SempaiEcchi/iot-quake/SEMINAR.pptx

Umreženi sustav za detekciju potresa

ESP32 · MPU6050 · MQTT · correlation rule dvaju channela

Leo Radočaj
Sveučilište Jurja Dobrile u Puli · Fakultet informatike u Puli
Seminarski rad iz kolegija Internet stvari (IoT) · 2025./2026.

Notes: Naslovna. Predstaviti temu: jedan jeftini node, ali s protokolom koji razlikuje lokalni noise od ground motiona.

## Slide 2

Problem: jedan senzor ne zna što je potres

Kamion, vrata, lakat na stolu

Lokalni noise. Trese jedan senzor, druge ne dotiče. Akcelerometar to vidi jednako kao potres.

Correlation rule

distinct channela
unutar 2 sekunde

Tek tada je to potres. Isti pristup koriste dense low-cost arrays (Community Seismic Network, MyShake): pouzdanost dolazi iz istodobnosti, ne iz kvalitete pojedinog senzora.

Scope: jedan ESP32. Drugi channel je simuliran (fake_node.py) i govori isti MQTT contract; stvarni drugi node je drop-in bez izmjene koda.

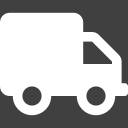
[picture p4: figure]

2

Ground motion

Pogađa sve senzore istodobno. Lokalni noise je lokalan, ground motion nije. To je jedina razlika koju možemo mjeriti jeftino.

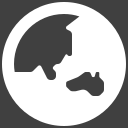
[picture p5: figure]

Leo Radočaj · Fakultet informatike u Puli

2

Notes: Motivacija. Jedan akcelerometar ne razlikuje lokalni noise od ground motiona; zahtjev da se dva channela slože je najjeftinija diskriminacija.

## Slide 3

Arhitektura sustava

ESP32 + MPU6050

channel A · stvarni

Correlator

python · paho-mqtt

quake/alarm

→ buzzer

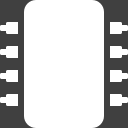
[picture p6: figure]

Mosquitto

MQTT broker · Docker

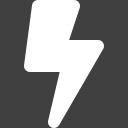
[picture p7: figure]
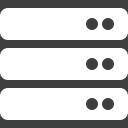
[picture p8: figure]

fake_node.py

channel B · simulirani

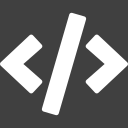
[picture p9: figure]

Dashboard

localhost:8000 · SSE

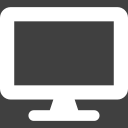
[picture p10: figure]

Thingsboard

optional

Dashboard subscribea na broker, ne na correlator

Detection ne smije ovisiti o tome je li browser otvoren. Gašenje dashboarda ne mijenja ništa u ponašanju alarma.

Leo Radočaj · Fakultet informatike u Puli

Broker ostaje lokalan

Demo preživljava nestanak interneta: eventi, korelacija, alarm i buzzer rade dalje. Bridge prema cloudu živi u correlatoru, pa node ostaje plaintext bez TLS-a.

3

## Slide 4

Hardver: ~¥3.100 na breadboardu

Komponenta | Kol. | Cijena
ESP32 (FREENOVE FNK0090, WROOM-32E, 4 MB) | 1 | ¥1.800
MPU6050 / GY-521 akcelerometar | 1 | ~¥300
Aktivni buzzer, 3-pin modul | 1 | ~¥100
Breadboard | 1 | ~¥300
Jumper wires | 1 set | ~¥400
LED 5 mm + otpornik 330 Ω | 1 | ~¥200

Wiring

MPU6050 VCC ── 3V3 (3,3 V, NE 5 V)
GND ── GND
SCL ── GPIO27
SDA ── GPIO26
LED ── GPIO2 (onboard)
Buzzer ── GPIO25

Izmjereno, ne pretpostavljeno

- FNK0090 ima 40 pinova, ne 38
- Buzzer je active-LOW
- MPU6050 treba ~150 ms settle nakon power-upa prije prvog I2C upita

Leo Radočaj · Fakultet informatike u Puli

4

## Slide 5

Firmware: sampling i detection

detector.cpp · bez Arduino headera · dev prema prethodnom baselineu

dev = |mag − baseline|
baseline = 0.99·baseline + 0.01·mag
if dev > THRESHOLD and not refractory:
trigger()

EMA kao high-pass filter

Uklanja ~980 gal gravity offseta bez filter biblioteke i prati nagib node-a. Deviation prema prethodnom baselineu: spike prijavi punu amplitudu.

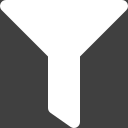
[picture p11: figure]

Warm-up 3 s

Baseline se seeda prvim sampleom, ali EMA se još smiruje. Prve 3 sekunde nema triggera.

Sampling

- 100 Hz, gate na micros(); ±2 g, 16384 LSB/g, gal = g · 980,665
- DLPF u senzoru (0x1A = 6) → bandwidth 5 Hz; bez toga noise je ~7× veći
- Sample gate se resyncira umjesto da sustiže: stall ne smije ispaliti burst
- MQTT reconnect s exponential backoffom (2 s → 30 s); blocking reconnect je rušio 100 Hz na 1 Hz

Leo Radočaj · Fakultet informatike u Puli

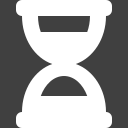
[picture p12: figure]

Refractory period 5 s

Jedan shake = jedan event, ne stotine. Publish kad se window zatvori: peak_gal je stvarni peak, dur_ms trajanje iznad thresholda.

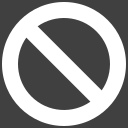
[picture p13: figure]

5

## Slide 6

MQTT contract: tri topica, tri JSON payloada

Topic | Smjer | Payload | Kada
quake/<node_id>/event | node → broker | {"node","peak_gal","dur_ms"} | na trigger
quake/<node_id>/tel | node → broker | {"node","dev_gal","uptime_s"} | 1 Hz
quake/alarm | correlator → node | {"nodes":[...],"peak_gal"} | na slaganje

Node ID iz MAC-a

node-a4c1f8: zadnja tri bajta WiFi MAC adrese. Bez konfiguracije po node-u, byte-identičan firmware.

Prefiksi sim- i mirror-

Simulirani i mirror channeli označeni su na razini protokola: nijedan log ni screenshot ne mogu ih prikazati kao stvarno mjerenje.

LED = channel, buzzer = mreža

LED se pali lokalno na trigger vlastitog channela. Buzzer se oglašava samo na quake/alarm: tek kad correlator potvrdi dva distinct channela.

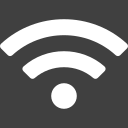
[picture p14: figure]
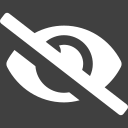
[picture p15: figure]
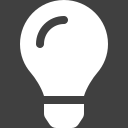
[picture p16: figure]

Leo Radočaj · Fakultet informatike u Puli

6

## Slide 7

Correlator: rule u četiri koraka

Primi event

Subscribe na quake/+/event. Arrival time, ne vrijeme node-a: bez NTP-a, jer je MQTT latency ~100 ms naspram window-a od 2 s.

Prune window

Odbaci sve unose starije od 2 s.

Broji distinct node-ove

Isti node dvaput nije slaganje. Trebaju ≥ 2 distinct ID-a.

Alarm + cooldown

Publish quake/alarm s max peak_gal, pa 10 s cooldowna: jedan potres, jedan alarm.

1

2

3

4

nodes = {e[0] for e in self._recent}
if len(nodes) < self.min_nodes: # 2
return None
self._last_alarm_at = now
return Alarm(nodes=sorted(nodes),
peak_gal=max(e[1] for e in self._recent))

Leo Radočaj · Fakultet informatike u Puli

Estimated shindo, nikad magnituda

- Tablica peak akceleracija → shindo živi u core.py; dashboard je importa, ne kopira, pa se ne mogu razići
- Magnituda traži udaljenost epicentra i dubinu: jedna postaja to ne može. Polje nosi „n/a“, ne praznu ćeliju

7

## Slide 8

Dashboard: jedna stranica, bez accounta, bez clouda

quake-net · localhost:8000

Leo Radočaj · Fakultet informatike u Puli

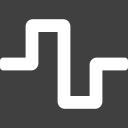
[picture p17: figure]

Live channeli

Trace dev_gal po channelu; 5 s bez telemetrije → offline

12

eventi

node-a4c1f8

3

alarmi

online

6

rejected

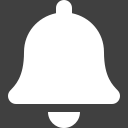
[picture p18: figure]

Event log

Alarmi istaknuti, s estimated shindom

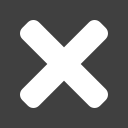
[picture p19: figure]

Rejected counter

Svaki event koji nije postao alarm bio bi na single-channel dizajnu false alarm. Headline brojka rada.

sim-000001

simulated

Oznaka „simulated“

sim-, mock-, mirror- channeli vidljivo označeni

Thingsboard ostaje spojen iza docker compose --profile cloud, ali ništa o njemu ne ovisi.

8

## Slide 9

Pure core + thin shell = testovi bez hardvera

Pure core (bez I/O-a, vrijeme kao parametar)

firmware/node/detector.cpp | bez Arduino headera
correlator/core.py | bez networka
sim/detector.py | Python port detectora

32

automatizirana testa
6 C++ · 26 pytest

Suite | Br. | Broker | Dokazuje
test_detector.cpp | 6 | ne | Algoritam u firmwareu
sim/test_parity.py | 6 | ne | Python port = firmware (load-bearing test)
correlator/test_core.py | 11 | ne | Correlation rule
sim/test_e2e.py | 3 | da | Mock node-ovi → alarm → buzzer
dashboard/test_dashboard.py | 6 | da | Agregacija statea

Thin shell (Wire, WiFi, MQTT, HTTP)

firmware/node/node.ino | Wire, WiFi, PubSubClient
correlator/main.py | paho-mqtt, Thingsboard
dashboard/server.py | MQTT + HTTP/SSE

Ako parity test padne, mock se razišao od firmwarea i simulacija prestaje nešto značiti.

Leo Radočaj · Fakultet informatike u Puli

9

## Slide 10

Rezultati: noise floor 0,733 gal → threshold 7,33 gal

0,733 gal

noise floor RMS, izmjereno

Multiplier | Threshold | Iznad / 177 s | Po satu | Shindo
3× | 2,20 gal | 60 | 1222 | 3, donji rub
5× | 3,67 gal | 0 | 0 | 3
10× (odabran) | 7,33 gal | 0 | 0 | 3 (2,5–8 gal)

3,295 gal

peak u 177 s (4,5 σ)

7,33 gal

threshold = 10× RMS

Što mjerenje pokazuje

- Ispod predviđenih 0,9 gal → noise floor je sensor-dominated, ne building-dominated. DLPF na 5 Hz radi
- 5× (spec) odbačen: 3,67 gal naspram peaka 3,295 gal u tri minute tihe sobe; tail 4,5 σ je teži od Gaussovog
- 10× pada na 7,33 gal i ostaje unutar shindo 3. Konzervativni multiplier i shindo 3 više nisu u napetosti
- Detection floor: shindo 3+. Shindo 1–2 je ispod noise floora senzora: hardversko ograničenje

Kalibracija 21. 8. 2026., board nepomičan na stolu, 177 s na 100 Hz, prve 3 s odbačene dok se EMA smiri. Sample rate potvrđen 100 Hz.

Leo Radočaj · Fakultet informatike u Puli

10

## Slide 11

Ograničenja, navedena unaprijed

Drugi channel je simuliran

Two-point fizička diskriminacija nije demonstrirana; protokol i correlation rule jesu.

Stvarni potres neće podići alarm

Trese samo stvarni node; simulirani channel triggera se ručno. Dokaz: event log + JMA.

Korelacija odbija samo channel-local noise

Koraci se prenose podom do svih senzora i koreliraju. To odbija samo amplitude threshold.

Nema epicentra

Traži sub-millisecond timing; WiFi to ne daje, jedan senzor pogotovo.

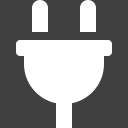
[picture p20: figure]
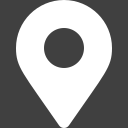
[picture p21: figure]

Nema službenog shinda ni magnitude

Samo peak akceleracija u gal i estimated intenzitet.

Leo Radočaj · Fakultet informatike u Puli

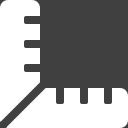
[picture p22: figure]

Detection floor oko shindo 3

Određen izmjerenim noise floorom MPU6050 od 0,733 gal RMS.

11

## Slide 12

Zaključak

Pure core ≠ shell

32 automatizirana testa za hardverski projekt. Većina bugova nađena prije nego što je hardver stigao.

Mjeriti, ne pretpostavljati

Izmjerenih 0,733 gal preokrenulo je preporuku iz speca (5× → 10×) i pokazalo da je floor sensor-dominated.

Poštenje na razini protokola

sim- i mirror- prefiksi: nijedan log, dashboard ni report ne može mirror prikazati kao drugu postaju.

Isporučeno: sampling 100 Hz s band-limitom u senzoru · EMA detection s warm-upom i refractory periodom · MQTT contract s tri topica · correlator „2 channela u 2 s“ · lokalni dashboard neovisan o internetu.
Sljedeći korak: drugi MPU6050 na 0x69 (AD0 high) ili drugi ESP32. Oboje drop-in bez izmjene koda; tek time se demonstrira stvarna two-point diskriminacija.

Izvori: Community Seismic Network (Caltech) · MyShake (Berkeley) · JMA Seismic Intensity Scale · InvenSense MPU-6050 datasheet · OASIS MQTT 5.0 · Eclipse Mosquitto · Espressif ESP32 datasheet · SEMINAR.md

Leo Radočaj · Fakultet informatike u Puli

12
