SempaiEcchi/iot-quake/(commit log)

2026-07-30 docs: design for two-node networked earthquake detector
    Correlation between two cheap ESP32+MPU6050 nodes replaces per-node
    sensor quality: an event counts only when both nodes trigger within 2s,
    so local vibration is rejected and ground motion is not.
    Records what was cut and why -- NTP sync (correlator stamps on arrival),
    JMA shindo formula (report gal instead), cloud broker (Mosquitto on the
    laptop over a phone hotspot avoids campus WiFi).
2026-07-30 docs: confirm ESP32 price, close open questions
    ESP32-DevKitC-32E is Y1800 at Akizuki (M-15673), not the Y1600 estimate;
    BOM total Y4700 -> Y5100.
    Replace the research placeholder section with the shindo-3+ frequency
    data (~5-7 opportunities per semester in Tokyo, flagged as approximate --
    sources disagree) and reduce the open questions to the one the build
    answers by itself: whether the noise floor is the sensor or the building.
    Threshold calibration measures it.
2026-07-30 docs: implementation plans for quake-net
    Six plans plus an index: procurement/assembly, node firmware, correlator,
    bringup/calibration, integration testing, public release.
    Both halves split a pure core from a thin I/O shell, so the detector and
    the correlation rule are unit-tested on the host with fake time before any
    hardware is involved.
    Self-review fixed three defects:
    - refractory test asserted 4 events in 20s, but events close at t=9000,
    14010, 19020 -- three. Extended to 25s.
    - integration test had the same off-by-one; an event publishes when its
    window closes, so the count lags the shake by one window.
    - spec called for per-node thresholds while also requiring byte-identical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
2026-07-30 docs: revise for one ESP32, cloud dashboard, and stall fix
    Grilling surfaced six changes:
    - One ESP32 available, not two. Channel B is now fake_node.py, which
    speaks the same MQTT contract so a real second node stays a drop-in.
    BOM Y5500 -> ~Y3100.
    - Docs referenced a dashboard in four places that no plan built. Added
    Thingsboard, fed by the correlator.
    - Broker stays local. Cloud platforms are broker-plus-dashboard but do
    not let an outside client subscribe to other devices' telemetry, so
    the correlator had nowhere to live. Correlator bridges to the cloud
    instead, which also keeps the node plaintext and the demo working
    when the internet is not.
    - net_pump() was documented as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
2026-08-18 feat: full implementation with hardware-free mock testing
    Firmware, correlator, and a mock layer that lets the whole system be run
    and debugged before any hardware exists.
    The mock node runs a Python port of detector.cpp against synthetic
    acceleration and speaks the real MQTT contract, so the detect -> publish
    -> correlate -> alarm -> buzz loop is exercised end to end on the laptop.
    sim/test_parity.py re-runs the six C++ detector cases against the port,
    because a mock that has drifted from the firmware tells you nothing.
    Mosquitto runs in Docker; Thingsboard is behind an optional compose
    profile so the default bring-up stays fast.
    Verified: 6 C++ detector tests, 6 parity, 8 correlator, 3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
    [calibrate.ino, detector.cpp, detector.h, i2c_scan.ino]
2026-08-18 fix: line-buffer stdout, handle stdin EOF
    Found by running the tools rather than only compiling them.
    fake_node.py dumped an EOFError traceback when stdin closed (piped
    input, or run detached). Now exits quietly.
    Event lines went missing from mock_node.py whenever output was
    redirected to a file: Python block-buffers a non-tty stdout, so a print
    only surfaced when a later flush happened to push the buffer. That made
    one shake look like it produced no event. Both scripts and the
    correlator now line-buffer stdout at startup, which covers multi-line
    prints that a per-print flush=True silently misses.
2026-08-18 docs: hardware-free firmware compile check
    Verified all three sketches build against esp32:esp32@3.3.11 with
    PubSubClient 2.8.0, and node.ino is clean under --warnings all. Records
    the flash/RAM figures (70% / 14%) so growth is noticeable later.
    Also notes that 'arduino-cli config init' errors when a config already
    exists, which is the first thing a returning reader hits.
2026-08-18 feat: band-limit the sensor, add web dashboard
    Two changes, one of them a correctness bug the test suite could not see.
    MPU6050 DLPF. The design's 0.9 gal noise floor assumes a 0.2-5 Hz band,
    but only the high-pass half existed: the EMA in detector.cpp. The sensor
    ran at its 260 Hz default, putting the real floor near 6 gal. Sampling
    at 100 Hz does not help - out-of-band noise aliases into the passband
    rather than disappearing. Left alone, calibration would have measured
    ~6 gal, the 10x rule would have set a ~60 gal threshold, and shindo 3
    (2.5-8 gal) would have been invisible while looking like a
    building-noise problem. CONFIG 0x1A = DLPF_CFG 6 -> 5 Hz, set in both
    node.ino and calibrate.i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
    [calibrate.ino, node.ino]
2026-08-18 docs: local dashboard is the presentation layer
    Thingsboard stays wired up behind --profile cloud for a rubric that wants
    a named IoT platform, but it is no longer described as the dashboard.
    Ours needs no account, no external service and no build step, works with
    the network unplugged, and is covered by six tests.
    Also reconciles the plans with what was actually built: 02 and 03 marked
    done, the index architecture and file map updated for docker/sim/
    dashboard, the DLPF register and the 5x-vs-10x threshold rule added to
    the global constraints, and plan 04 now starts the broker with docker
    compose rather than brew.
2026-08-20 docs: wiring guide and measured board facts
    Records the FNK0090's port, MAC and the 115200 upload-speed workaround, and
    adds docs/wiring.md covering the six-jumper layout, the one-free-hole
    constraint of a 38-pin board on a breadboard, and floor mounting.
2026-08-20 docs: FNK0090 pinout, two-board placement, buzzer test sketch
    Board is 40-pin, not 38, with spare 3V3 and GND pins that remove the need for
    power rails. Adds firmware/buzzer_test to identify whether the 3-pin module is
    active-HIGH, active-LOW or passive before node.ino relies on it.
    [buzzer_test.ino]
2026-08-20 test: pin sweep diagnostic, and hold the buzzer quiet during I2C scans
    GPIO25 floats after reset and some 3-pin modules sound on a floating input,
    which made repeated scan runs unpleasant. pin_sweep drives every output-capable
    header pin in turn to locate a miswired module.
    [i2c_scan.ino, pin_sweep.ino]
2026-08-20 feat: move I2C to GPIO26/27 and the LED to onboard GPIO2
    The FNK0090's left header carries 3V3, GND and GPIO25, so putting the bus on
    GPIO26/27 (left 10 and 11) keeps every wire on one breadboard instead of
    crossing to the second board for GPIO21/22.
    GPIO26 was previously LED_PIN, which would have collided. The board has an
    onboard LED on GPIO2, so the discrete LED and its resistor are dropped from the
    BOM entirely.
    GPIO12 was considered and rejected: it is a strapping pin, and the GY-521's
    onboard pull-ups would hold it high at boot and select 1.8V flash.
    [calibrate.ino, i2c_scan.ino, node.ino]
2026-08-20 test: I2C diagnostics for a non-responding sensor
    i2c_diag measures pull-up strength by driving each bus line low and counting
    reads until it recovers, which separates a real resistor on a powered module
    from a floating line that merely reads HIGH. The naive digitalRead check is
    misleading here: Wire.begin() enables the ESP32's internal pull-ups, and a
    floating line holds charge long enough to read HIGH on its own.
    i2c_watch polls 0x68 continuously so an intermittent contact on an unsoldered
    header shows up as a momentary hit.
2026-08-20 feat: node runs a simulated sensor when no MPU6050 answers
    Previously setup() spun forever if the sensor did not respond, so a node with
    a wiring fault was simply dead. It now falls back to synthesising acceleration
    -- gravity plus noise, with a burst on demand -- and feeds that through the
    same detector, the same event payload and the same MQTT topics. Only the
    source of the numbers differs, so the whole pipeline stays exercisable while
    hardware is unavailable.
    The BOOT button injects a shake by hand for demos, and a 12 s timer fires one
    unattended. mpu_init() is retried every 5 s, and a sensor plugged in later
    takes over with no reflash; the detector is re-initialised at that point so
    the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
    [line_probe.ino, node.ino]
2026-08-20 feat: two sensor channels per node, and isolate tests by topic prefix
    node.ino now drives two MPU6050s on one bus at 0x68 and 0x69 (AD0 low and
    high). Each is an independent channel with its own detector and node ID, so
    the correlator sees two agreeing sources from one board and the Python mock is
    no longer needed to demonstrate the alarm. Missing sensors fall back to
    simulation per channel and are re-probed every 5 s, so partial hardware works.
    Bus clock drops 400 kHz -> 100 kHz. Two sensors at 100 Hz is ~1.2 kB/s, so
    bandwidth is irrelevant, and the slower edges are what let the second sensor
    sit on a metre of cable. That separation matters: co-located sensors feel the
    same table bump, so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
    [node.ino]
2026-08-20 fix: log when a sensor drops off the bus
    A channel whose I2C read failed reverted to simulation silently, so it kept
    publishing plausible events that were not measurements and nothing downstream
    could tell. This surfaced with a flaky header: 0x68 answered mpu_init() at
    boot, then failed its first read, and the 81 gal 'events' were synthetic.
    [node.ino]
2026-08-20 docs: AD0 can be tied to sensor 2's own VCC
    Shorter than routing back to sensor 1, and the same node electrically. Notes
    the 5 V caveat, since tying AD0 to a 5 V supply would overdrive a 3.3 V input.
2026-08-20 test: boot chirp and alarm logging on the node
    A silent buzzer had two possible causes -- the node not receiving quake/alarm,
    or the wiring -- and no way to tell them apart. The node now chirps for 120 ms
    at boot, reports whether subscribe() succeeded, and logs each alarm it acts on,
    so the two cases are distinguishable from the serial log alone.
    [node.ino]
2026-08-20 fix: buzzer is active-LOW, invert it everywhere
    Measured, not assumed: the module is silent at HIGH and sounds at LOW. Driven
    the obvious way it screamed continuously and fell quiet for 1.5 s on each
    alarm -- inverted, and easy to misread as a broken alarm path.
    node.ino now uses BUZZ_ON/BUZZ_OFF rather than bare HIGH/LOW. The four
    diagnostic sketches parked GPIO25 LOW to 'keep the buzzer quiet', which did the
    opposite; they park it HIGH now.
    buzzer_test grew an onboard-LED indicator so the polarity question is
    answerable by looking at the board, without a serial monitor open.
    [buzzer_test.ino, i2c_diag.ino, i2c_scan.ino, i2c_watch.ino, line_probe.ino, node.ino]
2026-08-21 fix: back off MQTT reconnects, and report the real sample rate
    Sampling was measured at 1 Hz against an unreachable broker, against a nominal
    100. Each failed mqtt.connect() blocks for seconds while TCP times out, and
    retrying every 2 s left the loop spending nearly all its time inside connect().
    The sample gate resynced correctly, so nothing looked broken -- but detection
    during a network outage is the case the resync exists to protect, and at 1 Hz
    there is no detection to protect.
    Reconnects now back off 2 s -> 30 s, which keeps sampling above 90% through an
    outage, and reset to 2 s on success.
    publish_tel() also prints a health line with the measured samples-per-second
    and each channel'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
    [node.ino]
2026-08-21 feat: calibrate the threshold from measured noise, 7.33 gal
    177 s quiet-room capture: RMS 0.733 gal, peak 3.295 gal. The floor is below
    the ~0.9 gal the design predicted, which answers the spec's open question --
    it is sensor-dominated, not building-dominated, so the 5 Hz DLPF is working.
    That measurement reverses the spec's recommendation. 5x was preferred only
    because a 0.9 gal floor would put 10x at 9 gal, above shindo 3's 8 gal
    ceiling. Measured, 10x is 7.33 gal and sits inside the band, so the
    conservative multiplier and shindo 3 coverage stop being in tension.
    5x is also unsafe here on the evidence: 3.67 gal against an observed 3.295 gal
    peak in three minutes. That peak is 4.5 sigma,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
    [calibration-2026-08-21.csv]
2026-08-21 fix: stop the simulated channel from polluting real data
    Two behaviours were fine while both channels were synthetic and are wrong now
    that 0x68 is a real sensor.
    The sim channel auto-fired every 12 s, filling the earthquake log with
    fabricated entries interleaved with genuine measurements. The timer is off; the
    BOOT button is the only trigger, which also matches the design's rule that the
    simulated channel never echoes real events.
    Its shake was 80 gal. An alarm reports the maximum peak across channels, so a
    simulated 80 gal would swamp whatever the real sensor measured and every alarm
    would claim shindo 5+ regardless of ground truth. Now 12 gal -- shindo 4, a
    plausible reading for a seco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
    [node.ino]
2026-08-21 feat: mirror channel so one sensor can exercise the alarm path
    Channel B replays channel A's samples under a second node ID, giving the
    correlator two sources so the alarm and buzzer work with a single sensor.
    It is not a measurement and the code says so repeatedly. Same sensor, same
    sample, same instant -- it agrees with the real channel by construction, so the
    correlation rule can never reject anything and every alarm it produces is
    vacuous. This is the failure mode the design forbids for fake_node.py, adopted
    deliberately here and fenced off rather than hidden.
    The fencing is the important part: the node ID is prefixed 'mirror-', the
    dashboard tags those channels the way it tags synthet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
    [node.ino]
2026-08-21 fix: resolve the broker by mDNS, and let the sensor settle before probing
    The laptop's DHCP lease moved twice (.24 -> .17 -> .24) and each time the node
    silently failed to reach the broker -- still sampling, still logging, just
    never connected. It now resolves MQTT_HOSTNAME over mDNS with the literal IP
    as fallback, and logs which path it took. Confirmed resolving MEK14 to
    192.168.0.24.
    Separately, setup() probed the MPU6050 immediately after Wire.begin(), but the
    part needs ~100 ms after power-up. Every boot therefore printed
    'NO SENSOR - check wiring' and recovered silently on the 5 s retry, which is
    indistinguishable from a real wiring fault -- and this project has spent a lot
    of time ch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
    [node.ino]
2026-09-22 docs: seminar photos, dashboard and Thingsboard screenshots
    Also ignore .env.thingsboard, which holds the local device access token.
